hootmole/CO2-USB-sensor/Screenshot 2025-08-31 232222.png

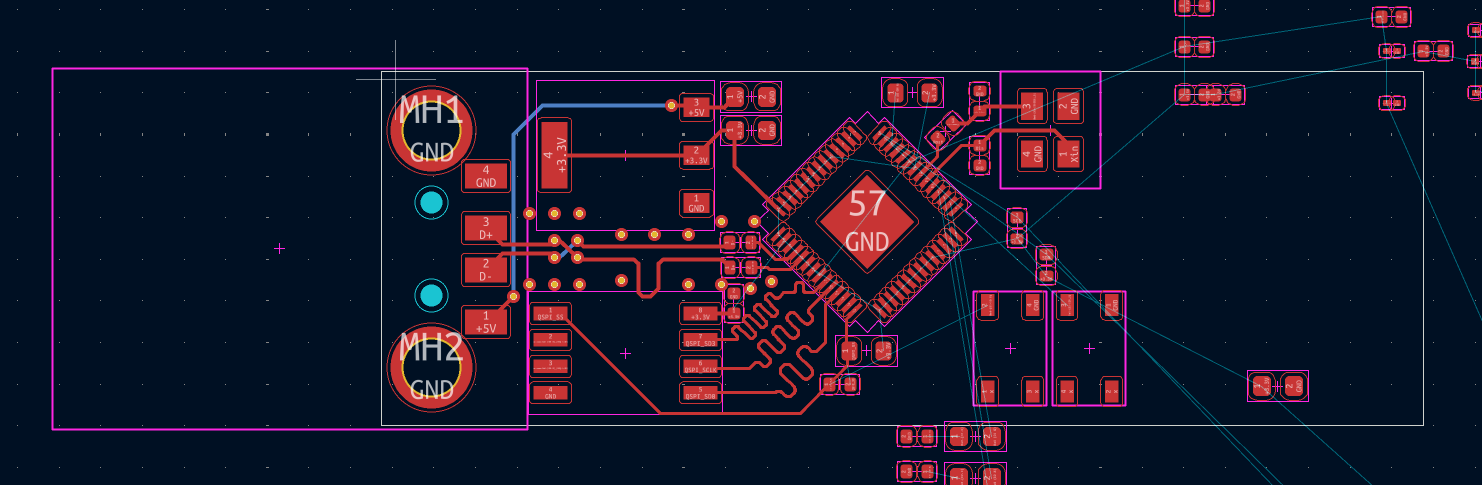
Screenshot 2025-08-31 232222.png
