hootmole/CO2-USB-sensor/CO2-sensor.kicad_pcb

## KiCad design CO2-sensor.kicad_pcb (2025-08-31)

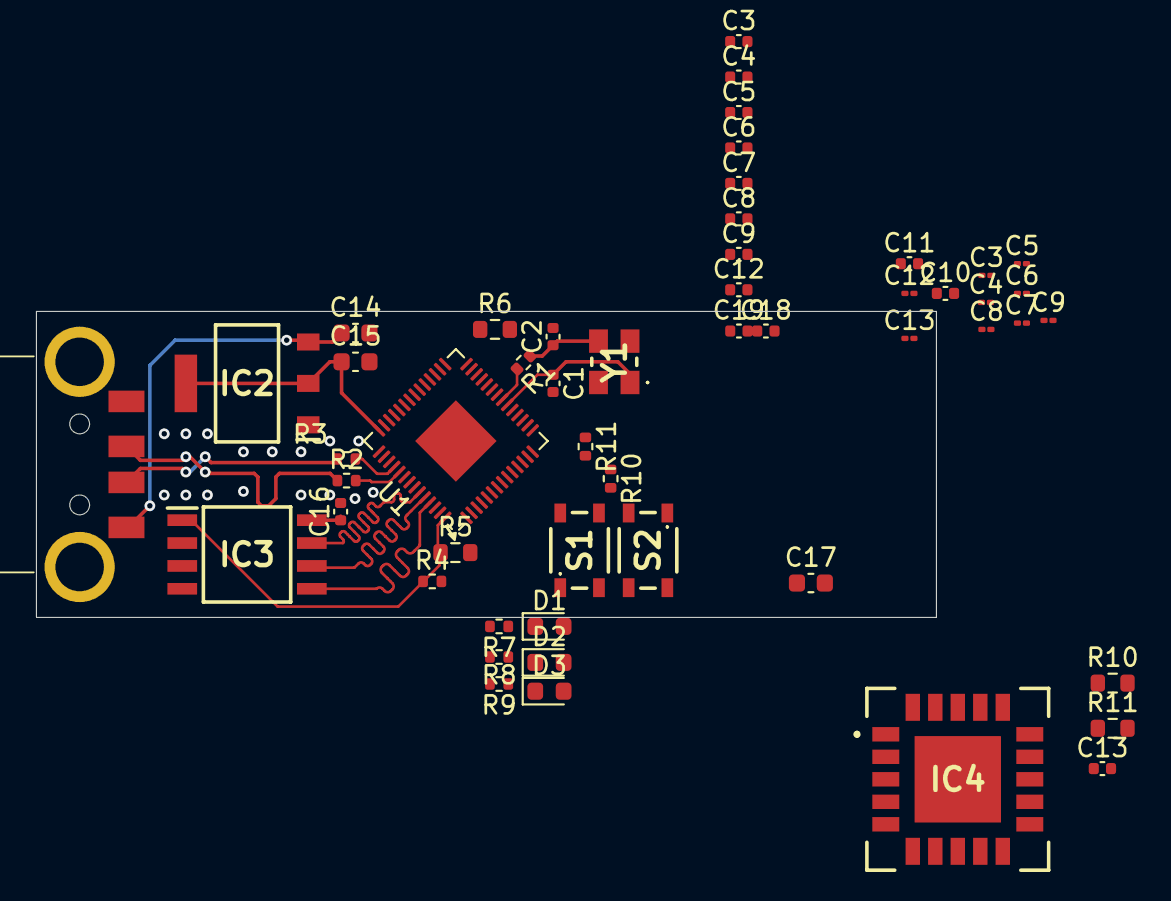
[picture p2: board CO2-sensor.kicad_pcb from above]

Board: 2 copper layers, 50.0 x 17.0 mm, 52 parts (0 on the bottom side), 25 nets.

Parts:
C1, C2: 15p; C_0402_1005Metric
C3, C4#2, C5#2, C6#2, C7, C8#2, C9, C12#2: 100n; C_01005_0402Metric
C3#2, C4, C5, C6, C7#2, C8, C9#2, C11, C12, C16, C18, C19: 100n; C_0402_1005Metric
C10, C13#2: 1u; C_0402_1005Metric
C13: 1u; C_01005_0402Metric
C14, C15, C17: 10u; C_0603_1608Metric
D1, D2, D3: LED; LED_0603_1608Metric
IC2: NCP1117ST33T3G; SOT230P700X180-4N
IC3: W25Q32JVSSIQ; SOIC127P790X216-8N
IC4: SCD40-D-R2; SCD40DR2
J1: 1734028-1; 17340281
R1, R4: 1k; R_0402_1005Metric
R2, R3: 27.4; R_0402_1005Metric
R5, R6, R10#2, R11#2: 10k; R_0603_1608Metric
R7, R8, R9: 100; R_0402_1005Metric
R10, R11: 10k; R_0402_1005Metric
S1, S2: TS20-42-25-WT-160-SMT-TR; TS204225WT160SMTTR
U1: RP2040; QFN-56-1EP_7x7mm_P0.4mm_EP3.2x3.2mm
Y1: ABM8-272-T3; ABM8272T3

Connections:
+3.3V: C3.1, C3#2.1, C4.1, C4#2.1, C5.1, C5#2.1, C6.1, C6#2.1, C7.1, C7#2.1, C8.1, C8#2.1, C9.1, C9#2.1, C10.1, C15.1, C16.1, C17.1, C18.1, C19.1, IC2.2 (OUTPUT_1), IC2.4 (OUTPUT_2), IC3.8 (VCC), IC4.7 (VDD), IC4.19 (VDDH), R5.2, R6.2, R10.2, R10#2.1, R11.2, R11#2.1, U1.1 (IOVDD), U1.10 (IOVDD), U1.22 (IOVDD), U1.33 (IOVDD), U1.42 (IOVDD), U1.43 (ADC_AVDD), U1.44 (VREG_IN), U1.48 (USB_VDD), U1.49 (IOVDD)
+5V: C14.1, IC2.3 (INPUT), J1.1
/QSPI_SCLK: IC3.6 (CLK), U1.52 (QSPI_SCLK)
/QSPI_SD0: IC3.5 (DI_(IO0)), U1.53 (QSPI_SD0)
/QSPI_SD3: IC3.7 (~HOLD_OR_/RESET_(IO3)), U1.51 (QSPI_SD3)
/QSPI_SS: IC3.1 (~CS), R4.2, R5.1, U1.56 (QSPI_SS)
/SCL: IC4.9 (SCL), R11.1, R11#2.2, U1.28 (GPIO17)
/SDA: IC4.10 (SDA), R10.1, R10#2.2, U1.27 (GPIO16)
/Xin: C1.1, U1.20 (XIN), Y1.1 (CRYSTAL_1)
/Xout: R1.2, U1.21 (XOUT)
D+: J1.3, R2.1
D-: J1.2, R3.1
GND: C1.2, C2.2, C3.2, C3#2.2, C4.2, C4#2.2, C5.2, C5#2.2, C6.2, C6#2.2, C7.2, C7#2.2, C8.2, C8#2.2, C9.2, C9#2.2, C10.2, C11.2, C12.2, C12#2.2, C13.2, C13#2.2, C14.2, C15.2, C16.2, C17.2, C18.2, C19.2, IC2.1 (ADJUST/GROUND), IC3.4 (GND), IC4.6 (GND_1), IC4.20 (GND_2), IC4.21 (GND_3), J1.4, J1.MH1, J1.MH2, R7.2, R8.2, R9.2, S1.4 (COM_2), S2.1 (NO_1), U1.19 (TESTEN), U1.57 (GND), Y1.2 (GND_1), Y1.4 (GND_2)
unnamed: D1.2 (A), U1.16 (GPIO13)
unnamed: D1.1 (K), R7.1
unnamed: D2.2 (A), U1.17 (GPIO14)
unnamed: D2.1 (K), R8.1
unnamed: D3.2 (A), U1.18 (GPIO15)
unnamed: D3.1 (K), R9.1
unnamed: R4.1, S1.2 (NO_2)
unnamed: R6.1, S2.3 (COM_1), U1.26 (RUN)
unnamed: R3.2, U1.46 (USB_DM)
unnamed: R2.2, U1.47 (USB_DP)
unnamed: C11.1, C12.1, C12#2.1, C13.1, C13#2.1, U1.23 (DVDD), U1.45 (VREG_VOUT), U1.50 (DVDD)
unnamed: C2.1, R1.1, Y1.3 (CRYSTAL_2)
