hootmole/CO2-USB-sensor/(commit log)

2025-08-30 First init
    [CO2-sensor.kicad_pcb, CO2-sensor.kicad_sch]
2025-08-31 removed components folder
    [CO2-sensor.csv, CO2-sensor.kicad_pcb, CO2-sensor.kicad_sch]
